Goodhao926/ESP-Lamp/readme.md

# ESP Lamp

### 

>  基于ESP8266开发的触摸灯
