Goodhao926/ESP-Lamp/程序设计/烧写说明.md

# 程序烧写说明

### 配置环境

- 下载Arduino，应用商城可下载
- 配置ESP库开发板管理网址
  - https://arduino.esp8266.com/stable/package_esp8266com_index.json
  - 
- 下载`FastLED库`
  - 

### 烧写注意

烧写时，请将项目配置如下图所示



### 测试程序

```c

#include "Arduino.h"
#include <FastLED.h>            // 此示例程序需要使用FastLED库
#define NUM_LEDS 20       // LED灯珠数量
#define LED_DT 5                // Arduino输出控制信号引脚
#define TOUCH 4                 // 触摸引脚
#define LED_TYPE WS2812B         // LED灯带型号
#define COLOR_ORDER GRB         // RGB灯珠中红色、绿色、蓝色LED的排列顺序
uint8_t max_bright = 200;       // LED亮度控制变量，可使用数值为 0 ～ 255， 数值越大则光带亮度越高
CRGB leds[NUM_LEDS];            // 建立光带leds
int mode_ = 0;// 0 关 1 一档 2 二档 3 三档
ICACHE_RAM_ATTR void onChange(){
  mode_++;
  if(mode_ == 4)mode_ = 0;
  switch(mode_){
    case 0:{
      FastLED.setBrightness(50);
      fill_solid(leds,NUM_LEDS,CRGB(0,0,0));
      FastLED.show();
      break;
    }
    case 1:{
      FastLED.setBrightness(50);
      fill_solid(leds,NUM_LEDS,CRGB(255,255,255));
      FastLED.show();
      break;
    }
    case 2:{
      FastLED.setBrightness(150);
      fill_solid(leds,NUM_LEDS,CRGB(255,255,255));
      FastLED.show();
      break;
    }
    case 3:{
      FastLED.setBrightness(200);
      fill_solid(leds,NUM_LEDS,CRGB(255,255,255));
      FastLED.show();
      break;
    }
  }
}

void setup() {
  Serial.begin(9600);
  // put your setup code here, to run once:
  LEDS.addLeds<LED_TYPE, LED_DT, COLOR_ORDER>(leds, NUM_LEDS);  // 初始化光带
  // put your main code here, to run repeatedly:
  FastLED.setBrightness(max_bright);                            // 设置光带亮度
  attachInterrupt(digitalPinToInterrupt(TOUCH) , onChange, CHANGE);

}

void loop() {
	delay(2000);
}
```

### 代码注意

- 在GPIO中断函数`attachInterrupt`第二个参数为中断id并不是GPIO口的序号，若将GPIO转中断id请使用

`digitalPinToInterrupt`函数

- 在中断回调函数前需要加入`ICACHE_RAM_ATTR`关键字，否则会出现`ESP8266`无线重启问题，至于为什么加，还在查文档.....
