Goodhao926/ESP-Lamp/电路设计/参考电路.md

[UART CH340C自动下载电路]  [立创EDA(标准版) - 免费、易用、强大的在线电路设计软件 (lceda.cn)](https://lceda.cn/editor#id=8f52c5cb3654462aacb51dbed85a23a3)

[ESP-12F ESP8266] 设计基本电路 [立创EDA(标准版) - 免费、易用、强大的在线电路设计软件 (lceda.cn)](https://lceda.cn/editor#id=8f52c5cb3654462aacb51dbed85a23a3)

[TYPE-C]  [立创EDA(标准版) - 免费、易用、强大的在线电路设计软件 (lceda.cn)](https://lceda.cn/editor#id=3de016f300fb45bda57b3fa74142225f)

[单通道触摸电路 RH6015C ]  [立创EDA(标准版) - 免费、易用、强大的在线电路设计软件 (lceda.cn)](https://lceda.cn/editor#id=6aef323fe42143d08a270d0fde878c5c)
