Goodhao926/ESP-Lamp/电路设计/焊接注意.md

# 焊接注意

1.注意各元器件的电气特性，主要是工作温度，切勿刚焊接好的`WS2812B`灯立刻通电测试，`WS2812`工作条件



会导致芯片烧坏，切记。
