Goodhao926/ESP-Lamp/电路设计/版本说明.md

# ESP Lamp 版本说明

V1.0存在R12和C3丝印位置存在不调换问题，0.1uF电容和 BOM表中封装不正确，购买时请注意

V2.0 修正R12 和 C3 丝印位置
