Goodhao926/ESP-Lamp/电路设计/5Vto3V3.png

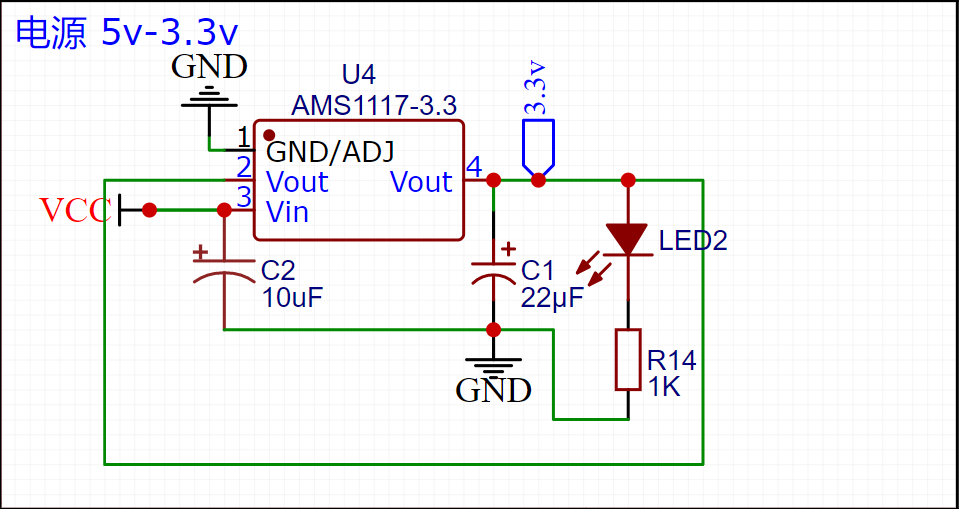
电路设计/5Vto3V3.png
