Goodhao926/ESP-Lamp/电路设计/触摸电路.png

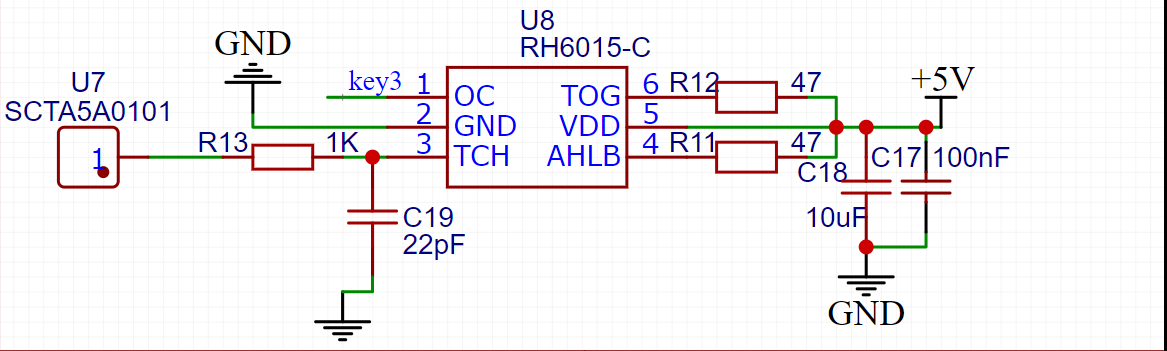
电路设计/触摸电路.png
