Goodhao926/ESP-Lamp/电路设计/Schematic_ESP8266-lamp_2021-08-08.pdf

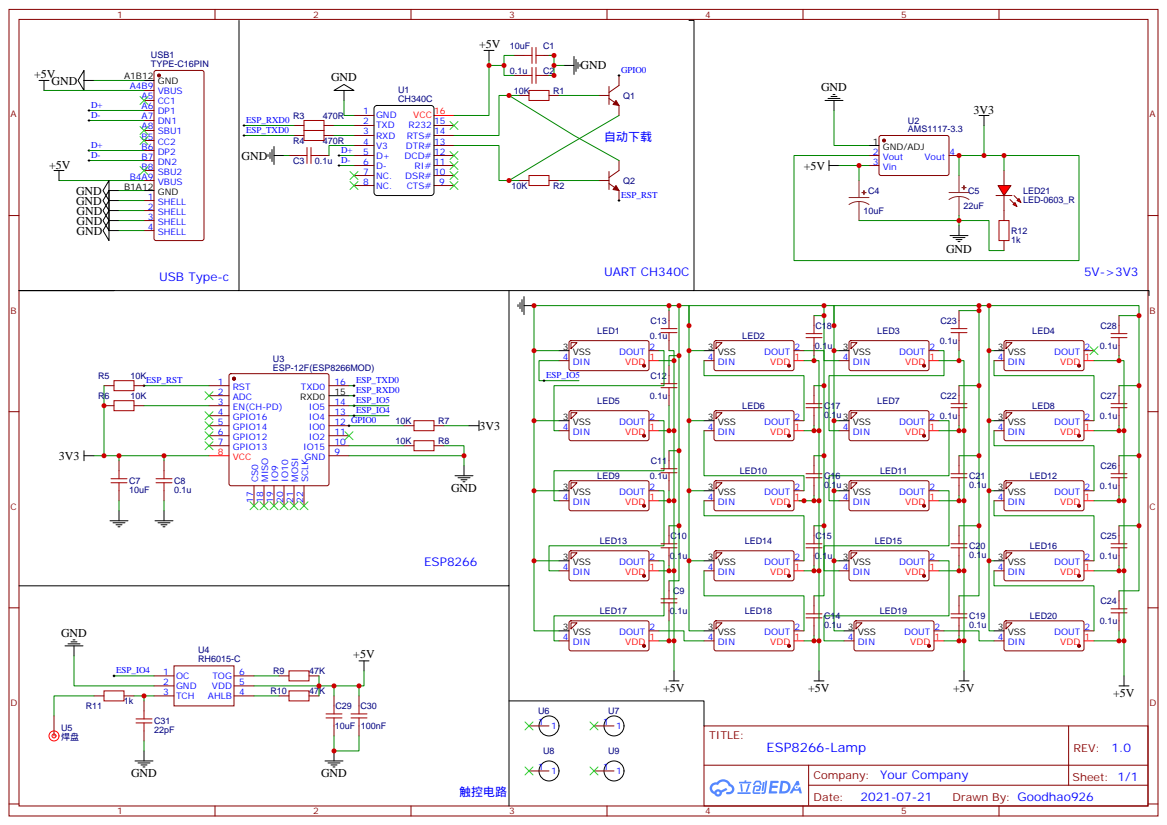
[picture p3: page 1]
