Goodhao926/ESP-Lamp/电路设计/BOM_ESP8266-lamp_2021-08-04.csv

ID | Name | Designator | Footprint | Quantity | Manufacturer Part | Manufacturer | Supplier | Supplier Part | Price | 获取方式 | 备注
1 | 10uF | C1,C7,C29 | C0402 | 3 | 0402X106M6R3 | Huaxin S&T | LCSC | C106833 | 0.2172 | 立创
2 | 0.1u | C2 | C0402 | 1 | 0402X104K160CT | Huaxin S&T | LCSC | C301997 | 0.01 | 存货
3 | 0.1u | C3,C8,C9,C10,C11,C12,C13,C14,C15,C16,C17,C18,C19,C20,C21,C22,C23,C24,C25,C26,C27,C28 | C0603 | 22 | 0402X104K160CT | Huaxin S&T | LCSC | C301997 | 0.01 | 立创
4 | 10uF | C4 | CASE-A_3216 | 1 | CA45P-P-10V-10uF-K | Shenzhen Zhenhua XinYun Elec | LCSC | C129234 | 0.5914 | 存货
5 | 22uF |  | CASE-A_3216 | 1 | CA45-A-10V-22μF-K | TORCH | LCSC | C503893 | 0.5758 | 立创
6 | 100nF | C30 | C0402 | 1 | 0402X104K160CT | Huaxin S&T | LCSC | C301997 | 0.01 | 存货
7 | 22pF | C31 | C0402 | 1 | GRM1552C1H220JA01D | MuRata | LCSC | C85935 | 0.0121 | 立创
8 | WS2812C | LED1,LED2,LED3,LED4,LED5,LED6,LED7,LED8,LED9,LED10,LED11,LED12,LED13,LED14,LED15,LED16,LED17,LED18,LED19,LED20 | LED-SMD_4P-L5.0-W5.0-TL | 19 | WS2812C | Worldsemi | LCSC | C114587 | 0.5807 | 淘宝0.25 | https://item.taobao.com/item.htm?spm=a1z0d.6639537.1997196601.26.ed007484Z8QIKh&id=573119701962
10 | LED-0603_R | LED21 | LED0603_RED | 1 | ORH-G36G | Orient | LCSC | C205443 | 0.056 | 存货
11 | 2N3904(SOT-23) | Q1,Q2 | SOT-23-3_L2.9-W1.3-P1.90-LS2.4-TR | 2 | S8050 | LGE | LCSC | C402279 | 0.0733 | 立创
12 | 10K | R1,R2,R5,R6,R7,R8 | R0402 | 6 | RC0402FR-0710KL | YAGEO | LCSC | C60490 | 0.0043 | 存货
13 | 470R | R3,R4 | R0603 | 2 | 0603WAF4700T5E | UniOhm | LCSC | C23179 | 0.009 | 立创
14 | 47K | R9,R10 | R0402 | 2 | AC0402JR-0747RL | YAGEO | LCSC | C227381 | 0.005 | 立创
15 | 1k | R11,R12 | R0402 | 2 | AECR0402F1K00K9 | ResistorToday | LCSC | C328304 | 0.0107 | 存货
16 | CH340C | U1 | SOP-16_L10.0-W3.9-P1.27-LS6.0-BL | 1 | CH340C | WCH | LCSC | C84681 | 2.93 | 淘宝2.48 | https://item.taobao.com/item.htm?spm=a1z0d.6639537.1997196601.15.ed007484Z8QIKh&id=559051930140
17 | AMS1117-3.3 | U2 | SOT-223-3_L6.5-W3.4-P2.30-LS7.0-BR | 1 | AMS1117-3.3 | AMS | LCSC | C6186 | 1.1034 | 存货
18 | ESP-12F(ESP8266MOD) | U3 | WIFIM-SMD_ESP-12F-ESP8266MOD | 1 | ESP-12F(ESP8266MOD) | Ai-Thinker | LCSC | C82891 | 9.16 | 淘宝6.8 | https://item.taobao.com/item.htm?spm=a1z0d.6639537.1997196601.37.ed007484Z8QIKh&id=540786885760
19 | RH6015-C | U4 | SOT-23-6_L2.9-W1.6-P0.95-LS2.8-BR | 1 | RH6015-C | RONGHE | LCSC | C78180 | 1.4168 | 淘宝0.82 | https://item.taobao.com/item.htm?spm=a1z0d.6639537.1997196601.4.ed007484Z8QIKh&id=601574108791
20 | 焊盘 | U5 | 焊盘 | 1
21 | M3_定位孔 | U6,U7,U8,U9 | M3_定位孔 | 4
22 | TYPE-C16PIN | USB1 | USB-C-SMD_TYPE-C16PIN | 1 | TYPE-C16PIN | SHOU HAN | LCSC | C393939 | 0.75 | 存货
